standakoukal/brink-flair-wifi/esphome/brink-flair-325.yaml

# ESPHome configuration for the Brink Flair 325 heat-recovery unit.
#
# Hardware: Seeed XIAO ESP32C3 + XIAO RS485 Expansion Board
# Bus:      Modbus RTU @ 19200 8N1, slave address 0x01
# Power:    24 V from the unit -> step-down 5 V/3 A -> XIAO 5V pin
#
# IMPORTANT pin map (ESP32C3 on the expansion board):
#   D4 = GPIO6  -> ESP TX (drives DI on the TP8485E)
#   D5 = GPIO7  -> ESP RX (reads RO from the TP8485E)
#   D2 = GPIO4  -> RS485 DE/RE (driver enable, HIGH = TX, LOW = RX)
#
# The Seeed wiki labels D4/D5 as "RX/TX" meaning the chip pins, NOT the
# ESP side - the inputs are flipped from the table. Confirmed by the
# community: see https://wiki.seeedstudio.com/XIAO-RS485-Expansion-Board/
# discussion (user Elu43, Jul 2025).
#
# Secrets are pulled from the ESPHome dashboard's shared secrets.yaml.
# Required keys:
#   wifi_ssid, wifi_password, ap_password, api_key, ota_password

substitutions:
  device_name: brink-flair-325
  friendly_name: "Brink Flair 325"

esphome:
  name: ${device_name}
  friendly_name: ${friendly_name}
  comment: "WiFi bridge to Brink Flair 325 over Modbus RTU"

esp32:
  board: seeed_xiao_esp32c3
  framework:
    type: arduino

# ESP32C3 XIAO has no exposed UART0 header - debug log goes over the
# built-in USB-Serial-JTAG interface so the hardware UART can be
# dedicated to Modbus.
logger:
  hardware_uart: USB_SERIAL_JTAG
  level: INFO

api:
  encryption:
    key: !secret api_key

ota:
  - platform: esphome
    password: !secret ota_password

wifi:
  ssid: !secret wifi_ssid
  password: !secret wifi_password
  ap:
    ssid: "${device_name} fallback"
    password: !secret ap_password

captive_portal:

# RS485 UART. flow_control_pin drives DE/RE on the expansion board.
uart:
  id: mod_bus
  tx_pin: GPIO6   # D4 -> DI of TP8485E
  rx_pin: GPIO7   # D5 <- RO of TP8485E
  baud_rate: 19200
  parity: NONE
  stop_bits: 1
  flow_control_pin:
    number: GPIO4
    inverted: false

modbus:
  id: modbus_hvac
  uart_id: mod_bus
  send_wait_time: 200ms

modbus_controller:
  - id: brink
    address: 0x01
    modbus_id: modbus_hvac
    setup_priority: -10
    update_interval: 30s

binary_sensor:
  - platform: status
    name: "Online"

text_sensor:
  - platform: wifi_info
    ip_address:
      name: "IP address"
    ssid:
      name: "Connected SSID"

  # Bypass state - 5-state enum from the official Brink UWA2-B Modbus
  # docs. The HA community thread's 3-state {Init/Open/Closed} mapping
  # is incomplete; the Flair 325 also reports the transitional states.
  - platform: template
    name: "Bypass state"
    id: bypass_state_text
    icon: mdi:valve
    lambda: |-
      auto raw = id(bypass_state_raw).state;
      if (isnan(raw)) return {"Unknown"};
      switch ((int) raw) {
        case 0:  return {"Initialize"};
        case 1:  return {"Opening"};
        case 2:  return {"Closing"};
        case 3:  return {"Open"};
        case 4:  return {"Closed"};
        default: return {"Unknown"};
      }
    update_interval: 30s

  # Filter status - simple binary per the UWA2-B docs (0 = clean,
  # 1 = dirty).
  - platform: template
    name: "Filter status"
    id: filter_status_text
    icon: mdi:air-filter
    lambda: |-
      auto raw = id(filter_status_raw).state;
      if (isnan(raw)) return {"Unknown"};
      return (int) raw == 0 ? std::string("Clean") : std::string("Dirty");
    update_interval: 60s

  # Unit operating mode - 15-state enum from the Brink UWA2-B Modbus
  # documentation. Value 12 ("Auto Modbus") is the steady state while
  # this ESP drives the unit through registers 8000-8002.
  - platform: template
    name: "Unit mode"
    id: unit_mode_text
    icon: mdi:state-machine
    lambda: |-
      auto raw = id(unit_mode_raw).state;
      if (isnan(raw)) return {"Unknown"};
      switch ((int) raw) {
        case 0:  return {"Standby"};
        case 1:  return {"Bootloader"};
        case 2:  return {"Non-blocking error"};
        case 3:  return {"Blocking error"};
        case 4:  return {"Manual"};
        case 5:  return {"Holiday"};
        case 6:  return {"Night ventilation"};
        case 7:  return {"Party"};
        case 8:  return {"Bypass boost"};
        case 9:  return {"Normal boost"};
        case 10: return {"Auto CO2"};
        case 11: return {"Auto eBus"};
        case 12: return {"Auto Modbus"};
        case 13: return {"Auto Portal"};
        case 14: return {"Auto Local"};
        default: return {"Unknown"};
      }
    update_interval: 30s

# All sensors live under a single top-level key. Diagnostics first,
# then Modbus reads.
# ---------------------------------------------------------------------------
# Read-only Modbus sensors. Register addresses come from the HA community
# thread:
# https://community.home-assistant.io/t/brink-flair-325-heat-recovery-unit-esphome-modbus-integration-5/423182
#
# All 4xxx status registers use Read Input Register (FC 0x04, ESPHome
# register_type: read), per the UWA2-B Modbus spec. The HA community
# thread implicitly used FC 0x03 (Read Holding) and got
# ILLEGAL_DATA_ADDRESS for the 4xxx range - that was the wrong function
# code. The 6xxx/8xxx registers are proper holding registers
# (read/write via FC 0x03 / 0x06).
# ---------------------------------------------------------------------------
sensor:
  - platform: wifi_signal
    name: "WiFi RSSI"
    update_interval: 60s

  - platform: uptime
    name: "Uptime"
    update_interval: 60s

  - platform: modbus_controller
    modbus_controller_id: brink
    name: "Supply temperature (to house)"
    id: supply_temp
    address: 4036
    register_type: read
    value_type: S_WORD
    unit_of_measurement: "°C"
    accuracy_decimals: 1
    device_class: temperature
    state_class: measurement
    filters:
      - multiply: 0.1

  - platform: modbus_controller
    modbus_controller_id: brink
    name: "Supply humidity"
    id: supply_humidity
    address: 4037
    register_type: read
    value_type: S_WORD
    unit_of_measurement: "%"
    accuracy_decimals: 0
    device_class: humidity
    state_class: measurement

  - platform: modbus_controller
    modbus_controller_id: brink
    name: "Exhaust temperature (to outside)"
    id: exhaust_temp
    address: 4046
    register_type: read
    value_type: S_WORD
    unit_of_measurement: "°C"
    accuracy_decimals: 1
    device_class: temperature
    state_class: measurement
    filters:
      - multiply: 0.1

  - platform: modbus_controller
    modbus_controller_id: brink
    name: "Exhaust humidity"
    id: exhaust_humidity
    address: 4047
    register_type: read
    value_type: S_WORD
    unit_of_measurement: "%"
    accuracy_decimals: 0
    device_class: humidity
    state_class: measurement

  - platform: modbus_controller
    modbus_controller_id: brink
    name: "Outdoor temperature (intake)"
    id: outdoor_temp
    address: 4081
    register_type: read
    value_type: S_WORD
    unit_of_measurement: "°C"
    accuracy_decimals: 1
    device_class: temperature
    state_class: measurement
    filters:
      - multiply: 0.1

  - platform: modbus_controller
    modbus_controller_id: brink
    name: "Supply airflow (actual)"
    id: supply_airflow
    address: 4032
    register_type: read
    value_type: U_WORD
    unit_of_measurement: "m³/h"
    accuracy_decimals: 0
    state_class: measurement

  - platform: modbus_controller
    modbus_controller_id: brink
    name: "Exhaust airflow (actual)"
    id: exhaust_airflow
    address: 4042
    register_type: read
    value_type: U_WORD
    unit_of_measurement: "m³/h"
    accuracy_decimals: 0
    state_class: measurement

  # Raw enum values - mapped to text by the template text_sensors above.
  - platform: modbus_controller
    modbus_controller_id: brink
    name: "Bypass state (raw)"
    id: bypass_state_raw
    address: 4050
    register_type: read
    value_type: S_WORD
    internal: true

  - platform: modbus_controller
    modbus_controller_id: brink
    name: "Unit mode (raw)"
    id: unit_mode_raw
    address: 4020
    register_type: read
    value_type: S_WORD
    internal: true

  - platform: modbus_controller
    modbus_controller_id: brink
    name: "Filter status (raw)"
    id: filter_status_raw
    address: 4100
    register_type: read
    value_type: S_WORD

# ---------------------------------------------------------------------------
# Writable controls
#
# When the bypass override is active (Bypass mode != Auto), the unit may
# ignore flow commands - test bypass first.
# ---------------------------------------------------------------------------
number:
  # Both Ventilation step (8001) and Flow setpoint (8002) drive the
  # fans when the matching Modbus control mode (8000) is selected:
  #   8000 = 1 (Step): write 0..3 to 8001, the unit runs at the m^3/h
  #                    preset stored in 6000..6003.
  #   8000 = 2 (Flow): write desired m^3/h to 8002, valid range
  #                    {0} U [50, 325] on the Flair 325.
  # Both styles work; pick whichever fits your HA UX.
  - platform: modbus_controller
    modbus_controller_id: brink
    name: "Ventilation step"
    id: ventilation_step
    address: 8001
    value_type: S_WORD
    register_type: holding
    min_value: 0
    max_value: 3
    step: 1
    mode: slider
    icon: mdi:fan

  - platform: modbus_controller
    modbus_controller_id: brink
    # Per the UWA2-B docs the valid write range is "Typ HRA: 0;
    # min. flow - max. flow". For the Flair 325 that is {0, 50..325}:
    # 0 is the extra "off" value and 50 m^3/h is the unit's minimum
    # flow. Values 1..49 return Modbus exception 3
    # (ILLEGAL_DATA_VALUE), confirmed empirically. The slider here is
    # capped at the regular 50..325 range; to actually stop the unit
    # use Modbus control mode = LCD or 8010 standby instead.
    name: "Flow setpoint"
    id: flow_setpoint
    address: 8002
    value_type: S_WORD
    register_type: holding
    min_value: 50
    max_value: 325
    step: 5
    unit_of_measurement: "m³/h"
    mode: slider
    icon: mdi:fan

  # Flow preset 0 = Holiday step, paired with 8001 = 0. Confirmed in
  # the official UWA2-B/UWA2-E installation regulations (page 11).
  # Default is appliance-dependent; on the Flair 325 it is around the
  # minimum supported flow.
  - platform: modbus_controller
    modbus_controller_id: brink
    name: "Flow level 0 (Holiday)"
    id: flow_level_0
    address: 6000
    value_type: U_WORD
    register_type: holding
    min_value: 0
    max_value: 325
    step: 5
    unit_of_measurement: "m³/h"
    mode: box

  - platform: modbus_controller
    modbus_controller_id: brink
    name: "Flow level 1"
    id: flow_level_1
    address: 6001
    value_type: U_WORD
    register_type: holding
    min_value: 50
    max_value: 325
    step: 5
    unit_of_measurement: "m³/h"
    mode: box

  - platform: modbus_controller
    modbus_controller_id: brink
    name: "Flow level 2"
    id: flow_level_2
    address: 6002
    value_type: U_WORD
    register_type: holding
    min_value: 50
    max_value: 325
    step: 5
    unit_of_measurement: "m³/h"
    mode: box

  - platform: modbus_controller
    modbus_controller_id: brink
    name: "Flow level 3"
    id: flow_level_3
    address: 6003
    value_type: U_WORD
    register_type: holding
    min_value: 50
    max_value: 325
    step: 5
    unit_of_measurement: "m³/h"
    mode: box

  # WARNING: 6035 and 6036 conflict between the HA community thread
  # (which calls them inflow/outflow imbalance, range -15..+15 %) and
  # the official UWA2-B docs (which call 6035 "Flow type" 0/1/2 and
  # 6036 "Switch default position" 0..3). On this Flair 325 both
  # registers read 0 idle, so we cannot tell from observation alone
  # which mapping applies. Keeping the community names for now. DO NOT
  # move the slider unless you have verified what the register really
  # does on your hardware - writing -15 to a register that expects 0..2
  # may push the unit into an error state.
  - platform: modbus_controller
    modbus_controller_id: brink
    name: "Inflow imbalance"
    id: inflow_imbalance
    address: 6035
    value_type: S_WORD
    register_type: holding
    min_value: -15
    max_value: 15
    step: 1
    unit_of_measurement: "%"
    mode: slider

  - platform: modbus_controller
    modbus_controller_id: brink
    name: "Outflow imbalance"
    id: outflow_imbalance
    address: 6036
    value_type: S_WORD
    register_type: holding
    min_value: -15
    max_value: 15
    step: 1
    unit_of_measurement: "%"
    mode: slider

select:
  - platform: modbus_controller
    modbus_controller_id: brink
    name: "Modbus control mode"
    id: modbus_mode
    address: 8000
    value_type: U_WORD
    optionsmap:
      "LCD (manual)": 0
      "Step": 1
      "Flow": 2

  - platform: modbus_controller
    modbus_controller_id: brink
    name: "Bypass mode"
    id: bypass_mode
    address: 6100
    value_type: U_WORD
    optionsmap:
      "Auto": 0
      "Closed": 1
      "Open": 2

switch:
  - platform: modbus_controller
    modbus_controller_id: brink
    name: "Bypass boost"
    id: bypass_boost
    address: 6104
    register_type: holding
    bitmask: 1
