standakoukal/brink-flair-wifi/(commit log)

2026-05-08 Initial project skeleton with wiring diagram
    - README with project overview and hardware list
    - docs/wiring.md: Mermaid + ASCII wiring diagram, Modbus settings,
    pre-power-on checklist, and corrected ESP32C3 pin map (RX=GPIO6,
    TX=GPIO7, DE/RE=GPIO4) since the HA community thread's GPIO 16/17
    applies to classic ESP32 only.
    - .gitignore for ESPHome secrets, build artifacts, VS Code, .claude/
    - .vscode/extensions.json with ESPHome, YAML, and Mermaid recommendations
2026-05-08 Add ESPHome config and Modbus register reference
    esphome/brink-flair-325.yaml:
    - Full configuration covering all registers known from the HA community
    thread: temperatures, humidities, airflows, bypass/unit/filter state,
    ventilation step, flow setpoint, flow levels, imbalance, modbus mode,
    bypass mode, bypass boost.
    - ESP32C3-correct pin map: UART RX=GPIO6, TX=GPIO7, DE/RE=GPIO4.
    - USB_CDC logger so the hardware UART stays free for Modbus.
    - Dashboard secrets (!secret) for wifi_ssid, wifi_password, ap_password,
    api_key, ota_password.
    - Bypass and unit mode raw values exposed as internal sensors and mapped
    to human-readable strings via template text_sensors.
    docs/registers.md:
    - Ta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
    [brink-flair-325.yaml]
2026-05-08 Add parametric OpenSCAD enclosure
    mechanical/enclosure.scad:
    - Parametric two-shell box (bottom + lid) for the XIAO ESP32C3 plus
    RS485 expansion stacked on friction-fit posts, with the step-down
    module bonded to the inside of the lid.
    - Side-wall cable inlets for 24 V and RS485 with strain-relief ribs
    for zip-ties.
    - USB-C slot at the rear so the XIAO can be re-flashed without opening
    the box.
    - Vent slots near the step-down zone.
    - Flat bottom face for 3M VHB mounting; M3 self-tap corner bosses.
    - PART selector renders bottom, lid, or an assembly preview.
    mechanical/README.md:
    - Tooling, measurement checklist, OpenSCAD workflow, slicer settings,
    and assembly steps. Calls out the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
    [enclosure.scad]
2026-05-08 Use USB_SERIAL_JTAG as logger UART on ESP32-C3
    USB_CDC is not a valid logger.hardware_uart value on the ESP32-C3 in
    ESPHome 2026.4.5. The runtime silently maps it to USB_SERIAL_JTAG, but
    this is suspected to corrupt the setup phase: the unit boots into safe
    mode (only wifi/api/ota/captive_portal/web_server.ota visible in the
    config dump, all Modbus and sensor components missing).
    Naming the JTAG interface explicitly aligns the YAML with what the
    runtime actually uses.
    [brink-flair-325.yaml]
2026-05-08 Use 2 stop bits for Brink Modbus RTU
    The Modbus RTU spec mandates 2 stop bits when parity is NONE; Brink and
    similar HRV vendors enforce it, silently dropping frames otherwise.
    Symptom on the wire: ESP transmits but never gets a response, log fills
    with "Stop waiting for response from 1" warnings. The HA community
    thread overlooks this detail.
2026-05-08 Swap RS485 RX/TX: D4=GPIO6 is TX, D5=GPIO7 is RX
    The Seeed wiki labels the pins D4="RX" and D5="TX", but those names
    refer to the TP8485E chip-side pins (RO and DI), not to the ESP side.
    From the MCU's perspective the roles are inverted:
    D4 = GPIO6 -> ESP TX (drives the chip's DI input)
    D5 = GPIO7 -> ESP RX (reads the chip's RO output)
    Wired the documented way, the firmware compiles, the Modbus stack runs,
    and the bus stays silent forever - every request times out with
    "Stop waiting for response from 1 ...ms after last send" because the
    ESP never actually drives DI.
    Confirmed by community user Elu43 in the Seeed wiki discussion (Jul
    2025). docs/wiring.md gets a heads-up box and a corre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
    [brink-flair-325.yaml]
2026-05-08 Switch 4xxx status sensors to FC 0x04 (input registers)
    On a Brink Flair 325 with Modbus enabled but no UWA2-B card every 4xxx
    status register returns Modbus exception 2 (ILLEGAL_DATA_ADDRESS) when
    read with FC 0x03 (Read Holding). The 6xxx/8xxx control registers work
    fine via FC 0x03.
    Hypothesis: the unit exposes status values through the input-register
    table (FC 0x04) instead, since the holding-table mapping is published
    by the UWA2-B firmware we don't have.
    This switches all temperatures, humidities, airflows, bypass state,
    unit mode, and filter status to register_type: read while keeping the
    6xxx/8xxx writable controls on register_type: holding.
    docs/registers.md: validation log with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
2026-05-08 Revert stop_bits to 1
    Empirically, this Brink Flair 325 (Modbus enabled, no UWA2-B) works
    with 8N1, not 8N2. The earlier change was a wrong guess; pin map was
    the actual cause of the bus silence.
    [brink-flair-325.yaml]
2026-05-08 Log raw enum values for Bypass and Unit mode
    The HA thread's enum mapping (Standby/Normal/Bootloader/Error for unit
    mode, Init/Open/Closed for bypass) does not match what the Brink Flair
    325 reports - both template text_sensors return "Unknown" even though
    the parent raw sensors read fine via FC 0x04.
    Lambdas now log the raw integer at INFO level on every update so the
    real values appear in the dashboard logs, and the default branch
    returns "Unknown(N)" so unmapped values are visible in HA too.
    docs/registers.md validation log: 4xxx status registers all confirmed
    working through FC 0x04 on a unit without the UWA2-B card. Two open
    items - the unit-mode and bypass-state enum mappings - docum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
    [brink-flair-325.yaml]
2026-05-08 Decode Unit mode and Bypass state with full Brink enums
    Source: official Brink UWA2-B Modbus documentation (mirrored in the
    TapHome integration). The HA community thread's 3-state bypass and
    4-state unit-mode mappings are incomplete for the Flair 325.
    Unit mode (4020) - 15 states. Value 12 ("Auto Modbus") is the steady
    state when this ESP drives the unit through registers 8000-8002.
    Bypass state (4050) - 5 states with separate transitional values.
    Value 3 ("Open") confirmed against the unit's LCD on a test bench.
    docs/registers.md gets the full enum tables and observed values from
    this unit so future changes can cross-check without spelunking the web
    again.
2026-05-08 Wrap up: bring-up complete, drop debug logging
    esphome/brink-flair-325.yaml: remove the ESP_LOGI debug lines from the
    Bypass / Unit-mode lambdas - both enums are decoded and verified, the
    default branch returning a fixed "Unknown" is enough.
    README.md: rewrite the status section now that all 20 entities read
    and write correctly. Add a "Key gotchas" section so the next reader
    (or me, in a year) doesn't repeat the same five mistakes:
    1. Seeed wiki RX/TX labels are chip-side, not ESP-side
    2. logger.hardware_uart on ESP32-C3 is USB_SERIAL_JTAG, not USB_CDC
    3. Brink without UWA2-B: control regs over FC 0x03, status regs over
    FC 0x04
    4. The bypass/unit-mode enums in the HA thread are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
    [brink-flair-325.yaml]
2026-05-08 Drop the mechanical/ enclosure draft
    The OpenSCAD enclosure was a first sketch with placeholder dimensions.
    Removing it for now; a better one will come once the actual board has
    been measured.
    [enclosure.scad]
2026-05-08 Constrain Ventilation step to 1-3, document new enum confirmations
    The HA thread claims register 8001 (Ventilation step) accepts 0-3,
    but the Flair 325 returns Modbus exception 3 (ILLEGAL_DATA_VALUE) for
    0. The number entity now caps at min_value: 1 so the HA slider can't
    emit an invalid write.
    To actually stop ventilation, set the Modbus control mode (8000) to
    LCD or set the Flow setpoint (8002) to 0 with 8000 = Flow. Documented
    in docs/registers.md.
    Two more enum cases verified during testing:
    - Bypass state 4 = Closed
    - Unit mode 4 = Manual (active when 8000 = LCD)
2026-05-08 Auto-switch Modbus control mode on Ventilation/Flow writes
    Register 8001 (Ventilation step) is writable only when 8000 (Modbus
    control mode) == Step; 8002 (Flow setpoint) only when 8000 == Flow.
    Otherwise the unit returns exception 3 (ILLEGAL_DATA_VALUE) - which
    explains the bursts of 0x86 errors when the HA slider is moved while
    the unit is in LCD mode.
    The on_value action now flips the control mode if necessary and
    re-issues the write 1 s later so the HA slider behaves as expected
    regardless of the previous mode. The recursion is bounded because the
    second write enters the on_value handler with mode == Step (or Flow),
    and the if-condition then short-circuits.
    [brink-flair-325.yaml]
2026-05-08 Stop the on_value retry loop and migrate off deprecated select.state
    The on_value handler that auto-switched Modbus control mode also
    re-issued the number write 1 s later. Combined with the modbus_controller
    re-publishing the state on every read, this created an infinite loop
    that flooded the bus and eventually pushed the modbus_controller
    offline:
    publish 50 -> on_value -> select.set -> delay 1s ->
    number.set 50 -> publish 50 -> on_value -> ...
    The retry is removed. on_value still flips the control mode when
    needed; if the first write races the mode switch, the user moves the
    slider once more and it goes through.
    Flow setpoint (8002) loses its on_value entirely - empirically the
    Flai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
    [brink-flair-325.yaml]
2026-05-08 Pin unit to Auto Modbus to make Ventilation step writes effective
    Symptom on the Flair 325 (no UWA2-B): a write to 8001 succeeds, the
    register reads back the new value, but the fans don't change speed
    and Unit mode (4020) silently switches from "Auto Modbus" (12) to
    "Manual" (4). In Manual the unit ignores 8001 entirely.
    The fix has two parts:
    1. Drop the on_value mode-switch handler from Ventilation step. It
    was written for the case where the user had moved the unit to LCD
    and the slider should switch back to Step. The Flair 325 doesn't
    actually misbehave that way - the real problem is Auto Modbus
    drift, which on_value cannot detect.
    2. Add an interval: 60s that watches the u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
    [brink-flair-325.yaml]
2026-05-08 Mark Ventilation step / Flow setpoint as read-only without UWA2-B
    Empirical conclusion after a full evening of testing on a Brink Flair
    325 with Modbus enabled in the menu but no UWA2-B card:
    - Writes to 8001 (Ventilation step) and 8002 (Flow setpoint) are
    acknowledged on the bus, the registers read back the new value,
    but the unit's front display never updates and the fans don't
    move. Unit mode (4020) just drops to "Manual" (4).
    - Flipping 8000 (Modbus control mode) between LCD/Step/Flow doesn't
    help - the unit never enters Auto Modbus (Unit mode = 12) without
    the UWA2-B card.
    Bottom line: direct fan control over Modbus needs UWA2-B. Without it,
    Modbus is good for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
    [brink-flair-325.yaml]
2026-05-08 Add Flow level 0 (Holiday) at register 6000
    Brink's step numbering is 0=Holiday / 1=Low / 2=Normal / 3=High; the
    existing entries cover 1/2/3 at 6001/6002/6003 but the Holiday flow
    setpoint at 6000 was missing. Address inferred by symmetry; if the
    Flair 325 does not expose 6000 the logs will show exception 2 and
    we'll comment the entry out.
    [brink-flair-325.yaml]
2026-05-08 Revert 8001/8002 to writable number, drop the 6000 guess
    I prematurely converted Ventilation step (8001) and Flow setpoint
    (8002) to read-only sensors after seeing the unit ignore writes. That
    was the wrong call: the registers are writable on the bus per the
    Brink Modbus docs and the original HA community thread, and the
    correct ESPHome shape is `number`. Whether the unit actually acts on
    the write depends on whether a UWA2-B card is installed - that is a
    hardware property, not a YAML one.
    Restoring the original `number` entities (slider 0-3 for step, slider
    0-280 m^3/h for flow) so the integration is shaped correctly for both
    hardware setups: with UWA2-B the slider works, without it the sl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
    [brink-flair-325.yaml]
2026-05-08 Cross-check register map against the official UWA2-B documentation
    Pulled the official Brink UWA2-B/UWA2-E installation regulations PDF
    and reviewed every register the project uses. Two real corrections,
    several documentation upgrades, one important warning surfaced.
    Real corrections:
    - 6000 Flow preset 0 (Holiday) DOES exist - the docs list it
    explicitly on page 11. Adding it back to the YAML as a writable
    number entity. It pairs with 8001 = 0 (Holiday step).
    - 4032, 4042 (airflows) and 6001-6003 (flow presets) are documented
    as Type: unsigned. Switched value_type from S_WORD to U_WORD.
    - 4100 Filter status is a 0/1 enum, not a bitfield as our YAML
    comment said. Added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
    [brink-flair-325.yaml]
2026-05-08 Flow setpoint: switch from box to slider, raise max to 325 m^3/h
    The slider mode matches the original HA community thread example and
    reads better for a continuous range. Max raised from 280 to 325 m^3/h
    - 325 is the actual top of the Flair 325's range.
2026-05-08 Cap Flow setpoint slider at 50..325 - the UWA2-B 'extra value 0' rule
    Empirical: writing values 1-49 to register 8002 returns Modbus
    exception 3 (ILLEGAL_DATA_VALUE). The UWA2-B docs explain why - the
    write data range is documented as "Typ HRA: 0; min. flow - max. flow".
    That syntax means {0} ∪ [min_flow, max_flow] - 0 is an extra allowed
    "off" value and the regular range starts at the unit's minimum flow,
    which on the Flair 325 is 50 m^3/h.
    The slider now caps at 50..325 to avoid the gap. To actually stop the
    unit, use Modbus control mode = LCD or register 8010 (standby), not a
    literal 0 on the flow setpoint.
    [brink-flair-325.yaml]
2026-05-08 Flow mode confirmed working without a UWA2-B card
    Empirical bring-up correction: register 8002 (Flow setpoint) DOES
    drive the fans on a Flair 325 without UWA2-B as long as 8000 is set
    to Flow mode. The earlier conclusion that all ventilation control
    needs UWA2-B was wrong - it only applies to Step mode (8001).
    Practical workflow on a bare Flair 325:
    - Modbus control mode = Flow
    - Move the Flow setpoint slider in HA (50..325 m^3/h)
    - The supply/exhaust airflow sensors track the new setpoint
    Step mode (8001) is still broken without UWA2-B - writes are
    acknowledged but the unit drops itself to Unit mode = Manual and the
    fans don't change. The Ventilation step slider stays in the YAML fo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
2026-05-08 Clarify hardware: UWA2-B is installed; both Step and Flow modes work
    Two corrections after talking through the hardware setup:
    1. The unit DOES have the UWA2-B base PCB. It has to - the RS485
    connector X15 lives on UWA2-B, so without it there'd be no Modbus
    connection at all. What the unit doesn't have is the UWA2-E Plus
    PCB (extension card with extra I/O, geo-heat exchanger, etc.).
    Earlier "without UWA2-B" wording in README, registers.md and the
    YAML comments was wrong throughout - now corrected.
    2. Step mode (8001) actually works just fine. My earlier observation
    that 8001 writes were ignored was caught at a moment when the unit
    was in a transitional state (or some m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
    [brink-flair-325.yaml]
2026-05-31 Add Home Assistant control package (CO2 ventilation + bypass free cooling)
    Two automations on top of the ESPHome Modbus integration, shipped as a HA
    package with UI-tunable input_* helpers (with defaults; the automations fall
    back to those defaults if a helper is absent):
    - CO2 ventilation (Flow mode, reg 8002): drives the unit from the worst
    (highest) of the four room CO2 sensors, mapped linearly to a flow setpoint
    rounded to 25 m3/h. Re-asserted every 5 min, which also recovers Flow mode
    and the setpoint after a unit power cycle.
    - Whole-house night/morning free cooling (bypass, reg 6100): opens the bypass
    when the house is warm and it is cooler outside. Uses the unit exhaust temp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
